theLastBandit/Jammacon/README.md

# Jammacon

Set of adapters to simplify connecting a home console to any Jamma compatible cabinet.

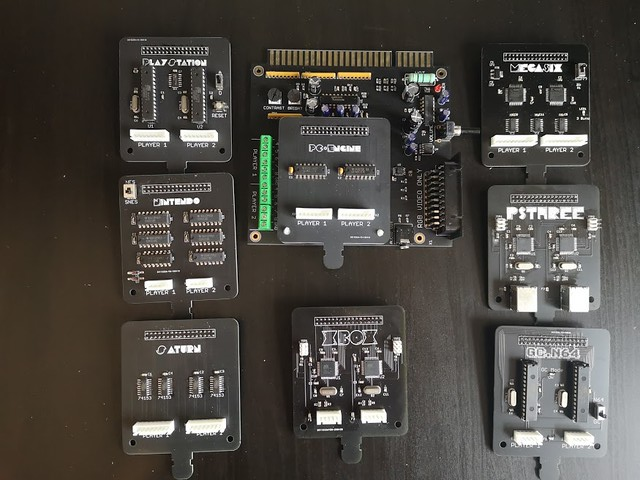
[picture p1: images/jammacon.jpg]
Boards
