theLastBandit/Jammacon/hardware/Readme.md

# BOM

Most components are sourced from either Farnell (F) or Mouser (M), suitable controller cables can be got on Ebay or Aliexpress.
|Board|Ref Des|Part Description|Quantity|Part Number|
|---|---|---|---|---|
|**JammaCon**| | | | |
| |R1, R2, R3, R12, R13, R14|75R SMD 0805|6|2057590 (F)|
| |R4|680K SMD 0805|1|2073825 (F)|
| |R5|2R7 SMD 0805|1|2447631 (F)|
| |R6, R7|10K SMD 0805|2|2073607 (F)|
| |R8, R9, R10|1K SMD 0805|3|2073611 (F)|
| |R11|5K1 SMD 0805|1|2073796 (F)|
| |R18|300R SMD 0805|1|2073728 (F)|
| |R15, R16, R17|430R SMD 0805|3|2138895 (F)|
| |R19, R20|100R SMD 0805|2|2073605 (F)|
| |R21|51K SMD 0805|1|2073797 (F)|
| |R22|3K9 SMD 0805|1|2073760 (F)|
| |R23|20R 5 Watt|1|1903920 (F)|
| |TR1, TR2|5K Trimmer Pot|2|9354697 (F) or 9608222 (F)|
| |POT1|100K Pot|1|1191735 (F)|
| |RN1, RN2, RN3, RN4|4K7 8 Way Resistor Network |4|9357025 (F)|
| |C1, C2, C3, C13, C14, C15, C16, C17, C20, C21, C22, C23, C24, C25, C4, C9|100nF SMD 0805|16|1759143 (F)|
| |C5, C6, C10, C11, C12,  C19, C26|10uF 50V|7|2346601 (F)|
| |C7|47pF SMD 0805|1|1759199 (F)|
| |C8|470uF 16V|1|1236664 (F)|
| |C18, C27|470uF 25V|2|2346508 (F)|
| |C5, C6, C10, C11, C12,  C19, C26|10uF 50V|7|9693769 (F)|
| |U1|TLS1233N Video Amplifier|1|595-TLS1233N (M)|
| |U2|LM1881N Sync Separator|1|1469221 (F)|
| |U3|LM384 Audio Amplifier|1|9488316 (F)|
| |U4|LDFMPT-TR Regulator|1|2460757 (F)|
| |F1|Fuse|1|2460757 (F)|
| |LED1|3mm Red LED|1|2112100 (F)|
| |X1|SCART Vertical Socket|1|806-K-SCARTX-024 (M)|
| |X2|Audio Jack|1|1608405 (F)|
| |X3|34 Pin IDC Male|1| |
| |X4|8 Way Terminal Block|1|3041517 (F)|
| | |PCB Standoff|2|1733396 (F)|
| | |10mm M3 screw|2|1419292 (F)|
|**Saturn**| | | | |
| |IC1, IC2, IC3, IC4|74HC153E|4|1753485 (F)|
| |C1, C2, C3, C4|100nF|4|2112751 (F)|
| |X1, X2|JST-XH 8 Way|2|1516284 (F)|
| |X3|34 Pin IDC Female|1| |
|**Saturn (SMD version)**| | | | |
| |IC1, IC2, IC3, IC4|74HC153D|4|1201248 (F)|
| |C1, C2, C3, C4|100nF SMD 0805|4|1759143 (F)|
| |X1, X2|JST-XH 8 Way|2|1516284 (F)|
| |X3|34 Pin IDC Female|1| |
|**PC-Engine**| | | | |
| |IC1, IC2|74HC157N|2|1750394 (F)|
| |C1, C2|100nF|2|2112751 (F)|
| |X1, X2|JST-XH 8 Way|2|1516284 (F)|
| |X3|34 Pin IDC Female|1| |
|**PC-Engine (SMD version)**| | | | |
| |IC1, IC2|74HC157D|2|1085334 (F)|
| |C1, C2|100nF SMD 0805|2|1759143 (F)|
| |X1, X2|JST-XH 8 Way|2|1516284 (F)|
| |X3|34 Pin IDC Female|1| |
|**Megadrive**| | | | |
| |IC1, IC2|74HC157|2|1750394 (F)|
| |C1, C2|100nF|2|2112751 (F)|
| |X1, X2|JST-XH 10 Way|2|1516286 (F)|
| |X3|34 Pin IDC Female|1| |
|**SNES**| | | | |
| |U1, U2, U3, U4|CD4021|4|2256617 (F)|
| |U5|CD4071|1|1106115 (F)|
| |U6|CD4077|1|1739911 (F)|
| |C1, C2, C3, C4, C5, C6|100nF|6|2112751 (F)|
| |D1, D2|IN4148 Diode|2|9565124 (F)|
| |S1|Switch|1|2435095 (F)|
| |X1, X2|JST-XH 5 Way|2|1516281 (F)|
| |X3|34 Pin IDC Female|1| |
|**SNES (SMD version)**| | | | |
| |U1, U2, U3, U4|CD4021|4|3120814 (F)|
| |U5|CD4071|1|3006431 (F)|
| |U6|CD4077|1|3006434 (F)|
| |C1, C2, C3, C4, C5, C6|100nF SMD 0805|6|1759143 (F)|
| |D1, D2|IN4148 Diode|2|9565124 (F)|
| |S1|Switch|1|2435095 (F)|
| |X1, X2|JST-XH 5 Way|2|1516281 (F)|
| |X3|34 Pin IDC Female|1| |
|**Playstation**| | | | |
| |U1, U2|ATMega328|2|1972087 (F)|
| |U3|75LVC07ADR|1|9592660 (F)|
| |C1, C2, C7|100nF SMD 0805|3|1759143 (F)|
| |C4, C5, C6, C3|22pF SMD 0805|1759195 (F)|
| |R1|10K SMD 0805|1|2073607 (F)|
| |Z1, Z2|16MHz Crystal|2|1611761 (F)|
| |X1, X2|JST-XH 8 Way|2|1516284 (F)|
| |X3|34 Pin IDC Female|1| |
| |S1|Switch|1|1201430 (F)|
| |S2|Button|1| |
|**XBOX**| | | | |
| |U1, U2|ATMega32U4|2|1748525 (F)|
| |C1, C2, C3, C4, C5, C6, C9, C13|100nF SMD 0805|8|1759143 (F)|
| |C7, C8, C11, C12|22pF SMD 0805|4|1759195 (F)|
| |R1, R6|10K SMD 0805|2|2073607 (F)|
| |C10, C14|1uF|2|2320853 (F)|
| |Q1, Q2|16MHz Crystal|2|1611761 (F)|
| |R3, R4, R5, R2|22R SMD 0805|4|2447609 (F)|
| |F1,F2|Fuse|2|581-F0805B0R25FSTR (M)|
| |X1, X2|JST-XH 5 Way|2|1516281 (F)|
| |X3|34 Pin IDC Female|1| |
|**PS3**| | | | |
| |U1, U2|ATMega32U4|2|1748525 (F)|
| |C1, C2, C3, C4, C5, C6, C9, C13|100nF SMD 0805|8|1759143 (F)|
| |C7, C8, C11, C12|22pF SMD 0805|4|1759195 (F)|
| |R1, R6|10K SMD 0805|2|2073607 (F)|
| |C10, C14|1uF|2|2320853 (F)|
| |Q1, Q2|16MHz Crystal|2|1611761 (F)|
| |R3, R4, R5, R2|22R SMD 0805|4|2447609 (F)|
| |F1,F2|Fuse|2|581-F0805B0R25FSTR (M)|
| |X1, X2|USB-A|2|1097897 (F)|
| |X3|34 Pin IDC Female|1| |
|**Megadrive 6**| | | | |
| |IC1, IC4|XC9536XL|2|2831292 (F)|
| |IC2, IC3, IC6|74HC125D|3|1201318 (F)|
| |IC5|3V3 LDO Regulator|1|3257431 (F)|
| |QG1, QG2|10 MHz Oscillator|2|2854358 (F)|
| |C1, C3|4.7uF|2|2409055 (F)|
| |C2, C4, C5, C6, C7, C8, C9, C10, C11, C12, C13|100nF SMD 0805|11|1759143 (F)|
| |R1|300R SMD 0805|1|2073728 (F)|
| |LED1|Red LED|1|2099236 (F)|
| |SW1|Switch|1|1201430 (F)|
| |X1, X2|JST-XH 10 Way|2|1516286 (F)|
| |X3|34 Pin IDC Female|1| |
|**Gamecube & N64**| | | | |
| |U1, U2|ATmega328|2|1972087 (F)|
| |C1, C2|100nF SMD 0805|2||1759143 (F)|
| |C3, C4, C5, C6|22pF SMD 0805|4|1759195 (F)|
| |XTAL1, XTAL2|16MHz Crystal|2|1611761 (F)|
| |R1|300R SMD 0805|1|2073728 (F)|
| |LED1|Red LED|1|2099236 (F)|
| |F1|Fuse|1|581-F0805B0R25FSTR (M)|
| |SW1|Switch|1|1201430 (F)|
| |X1, X2|JST-XH 5 Way|2|1516281 (F)|
| |X3|34 Pin IDC Female|1| |
|**Cables**| | | | |
| | |JST-XH 5 Way| |1516268 (F)|
| | |JST-XH 8 Way| |1516271 (F)|
| | |JST-XH 10 Way| |1516273 (F)|
| | |JST-XH Crimp| |1516301 (F)|
