theLastBandit/Jammacon/hardware/jammacon/jc_audio.kicad_sch

## KiCad design hardware/jammacon/jc_audio.kicad_sch (2022-03-14)

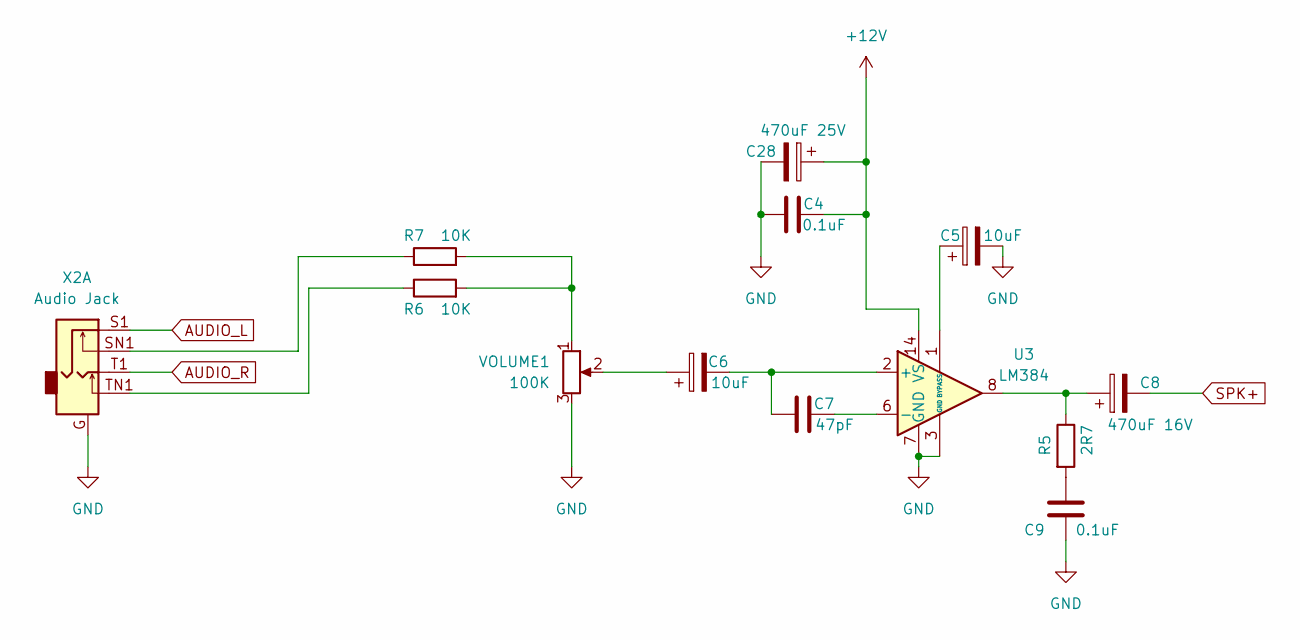
[picture p10: schematic jc_audio.kicad_sch]

Parts:
C4, C9: 0.1uF
C5, C6: 10uF
C7: 47pF
C8: 470uF 16V
C28: 470uF 25V
R5: 2R7
R6, R7: 10K
U3: LM384; DIP-14_W7.62mm
VOLUME1: 100K
X2: Audio Jack

Connections:
+12V: C4.2, C28.1, U3.14 (VS)
AUDIO_L: X2.S1
AUDIO_R: X2.T1
GND: C4.1, C5.2, C9.1, C28.2, U3.3 (GND), U3.4 (GND), U3.5 (GND), U3.7 (GND), U3.10 (GND), U3.11 (GND), U3.12 (GND), VOLUME1.3, X2.G
unnamed: C5.1, U3.1 (BYPASS)
unnamed: C6.1, VOLUME1.2
unnamed: C6.2, C7.1, U3.2 (+)
unnamed: C7.2, U3.6 (-)
unnamed: C8.1, R5.1, U3.8
unnamed: C9.2, R5.2
unnamed: R6.1, X2.TN1
unnamed: R6.2, R7.2, VOLUME1.1
unnamed: R7.1, X2.SN1
SPK+: C8.2
