theLastBandit/Jammacon/hardware/jammacon/jc_io.kicad_sch

## KiCad design hardware/jammacon/jc_io.kicad_sch (2022-03-14)

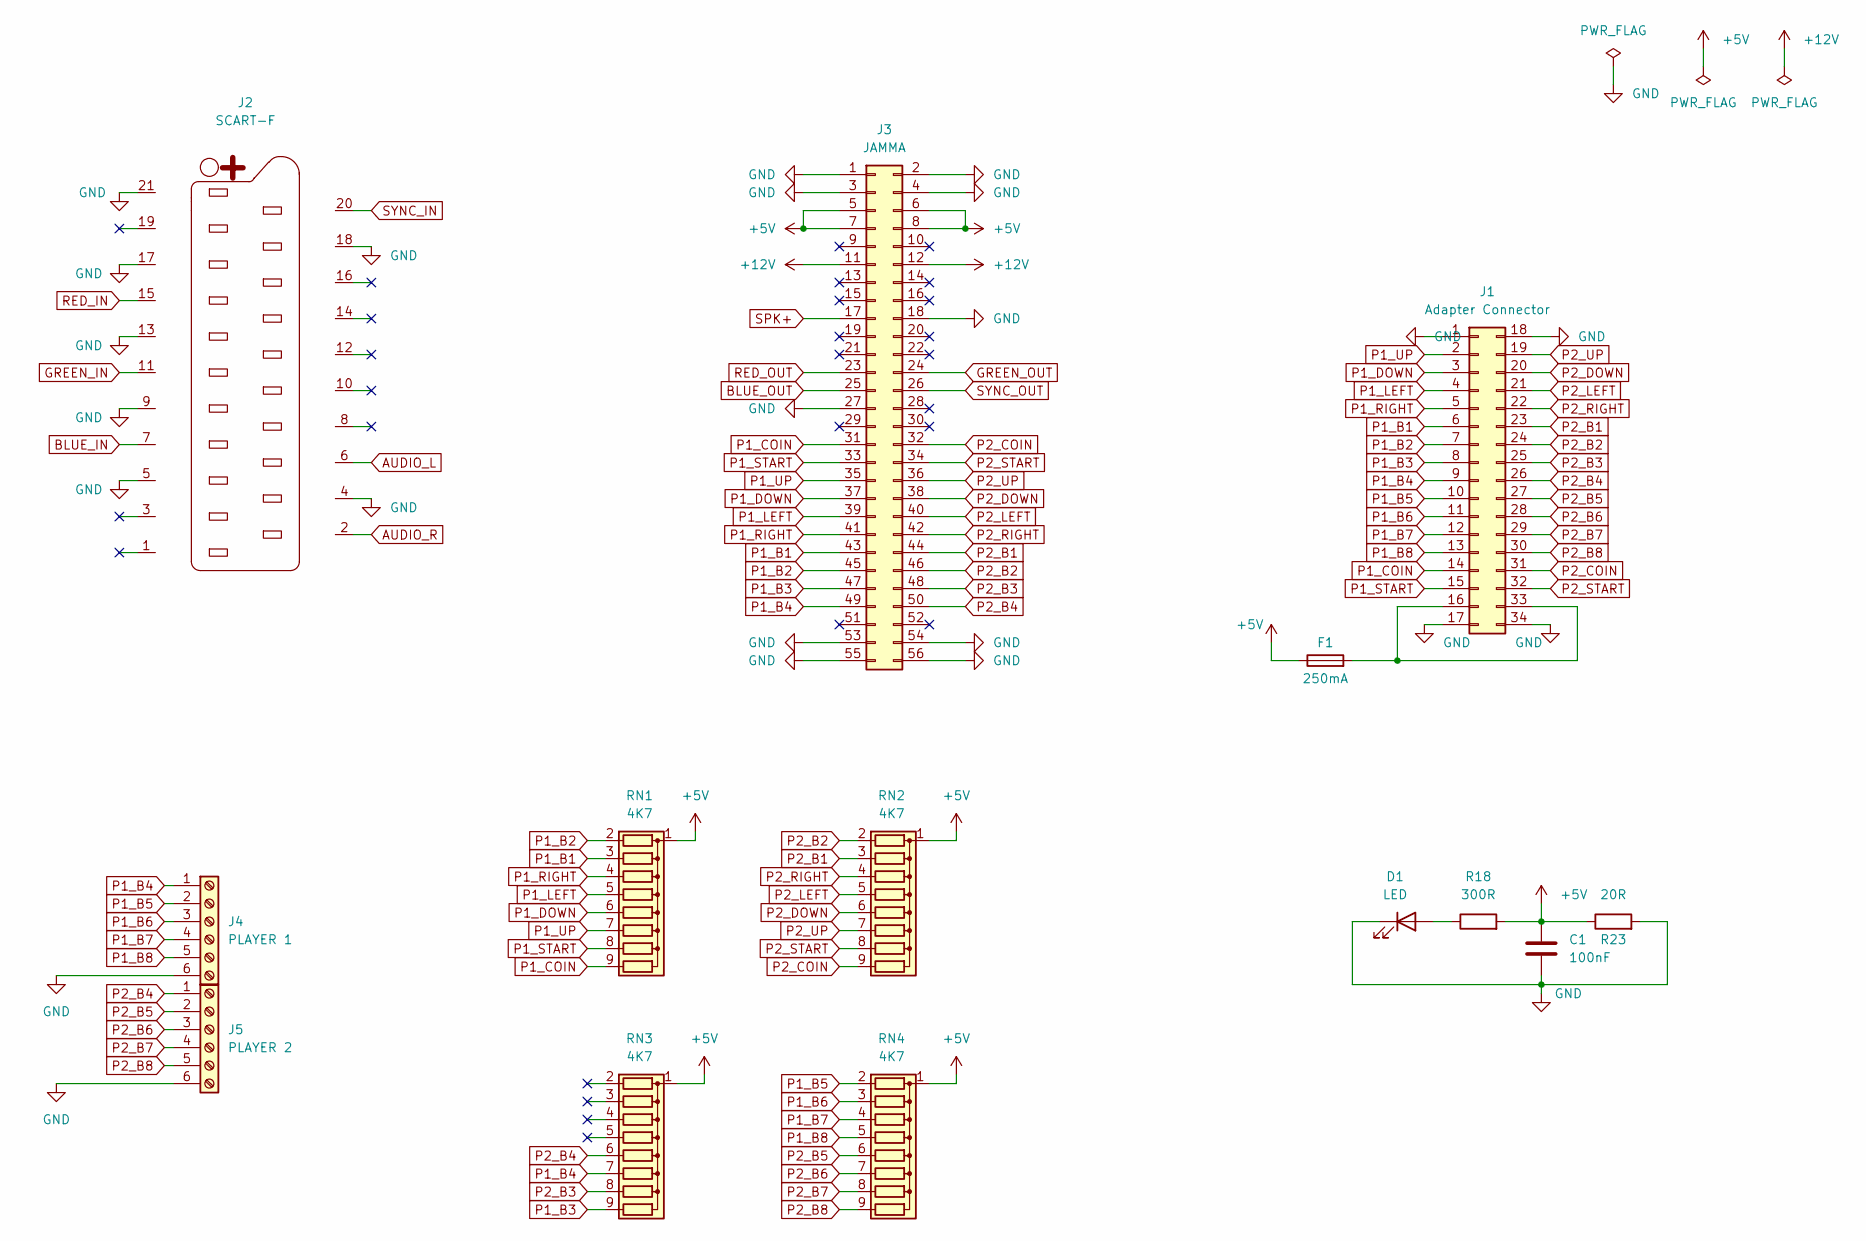
[picture p11: schematic jc_io.kicad_sch]

Parts:
C1: 100nF
D1: LED
F1: 250mA
J1: Adapter Connector
J2: SCART-F
J3: JAMMA
J4: PLAYER 1
J5: PLAYER 2
R18: 300R
R23: 20R
RN1, RN2, RN3, RN4: 4K7; R_Array_SIP9

Connections:
+5V: C1.1, F1.1, J3.5, J3.6, J3.7, J3.8, R18.2, R23.1, RN1.1 (common), RN2.1 (common), RN3.1 (common), RN4.1 (common)
+12V: J3.11, J3.12
AUDIO_L: J2.6
AUDIO_R: J2.2
BLUE_IN: J2.7
BLUE_OUT: J3.25
GND: C1.2, D1.1 (K), J1.1, J1.17, J1.18, J1.34, J2.4, J2.5, J2.9, J2.13, J2.17, J2.18, J2.21, J3.1, J3.2, J3.3, J3.4, J3.18, J3.27, J3.53, J3.54, J3.55, J3.56, J4.6, J5.6, R23.2
GREEN_IN: J2.11
GREEN_OUT: J3.24
unnamed: D1.2 (A), R18.1
unnamed: F1.2, J1.16, J1.33
P1_B1: J1.6, J3.43, RN1.3 (R2)
P1_B2: J1.7, J3.45, RN1.2 (R1)
P1_B3: J1.8, J3.47, RN3.9 (R8)
P1_B4: J1.9, J3.49, J4.1, RN3.7 (R6)
P1_B5: J1.10, J4.2, RN4.2 (R1)
P1_B6: J1.11, J4.3, RN4.3 (R2)
P1_B7: J1.12, J4.4, RN4.4 (R3)
P1_B8: J1.13, J4.5, RN4.5 (R4)
P1_COIN: J1.14, J3.31, RN1.9 (R8)
P1_DOWN: J1.3, J3.37, RN1.6 (R5)
P1_LEFT: J1.4, J3.39, RN1.5 (R4)
P1_RIGHT: J1.5, J3.41, RN1.4 (R3)
P1_START: J1.15, J3.33, RN1.8 (R7)
P1_UP: J1.2, J3.35, RN1.7 (R6)
P2_B1: J1.23, J3.44, RN2.3 (R2)
P2_B2: J1.24, J3.46, RN2.2 (R1)
P2_B3: J1.25, J3.48, RN3.8 (R7)
P2_B4: J1.26, J3.50, J5.1, RN3.6 (R5)
P2_B5: J1.27, J5.2, RN4.6 (R5)
P2_B6: J1.28, J5.3, RN4.7 (R6)
P2_B7: J1.29, J5.4, RN4.8 (R7)
P2_B8: J1.30, J5.5, RN4.9 (R8)
P2_COIN: J1.31, J3.32, RN2.9 (R8)
P2_DOWN: J1.20, J3.38, RN2.6 (R5)
P2_LEFT: J1.21, J3.40, RN2.5 (R4)
P2_RIGHT: J1.22, J3.42, RN2.4 (R3)
P2_START: J1.32, J3.34, RN2.8 (R7)
P2_UP: J1.19, J3.36, RN2.7 (R6)
RED_IN: J2.15
RED_OUT: J3.23
SPK+: J3.17
SYNC_IN: J2.20
SYNC_OUT: J3.26
