theLastBandit/Jammacon/hardware/jammacon/jc_video.kicad_sch

## KiCad design hardware/jammacon/jc_video.kicad_sch (2022-03-14)

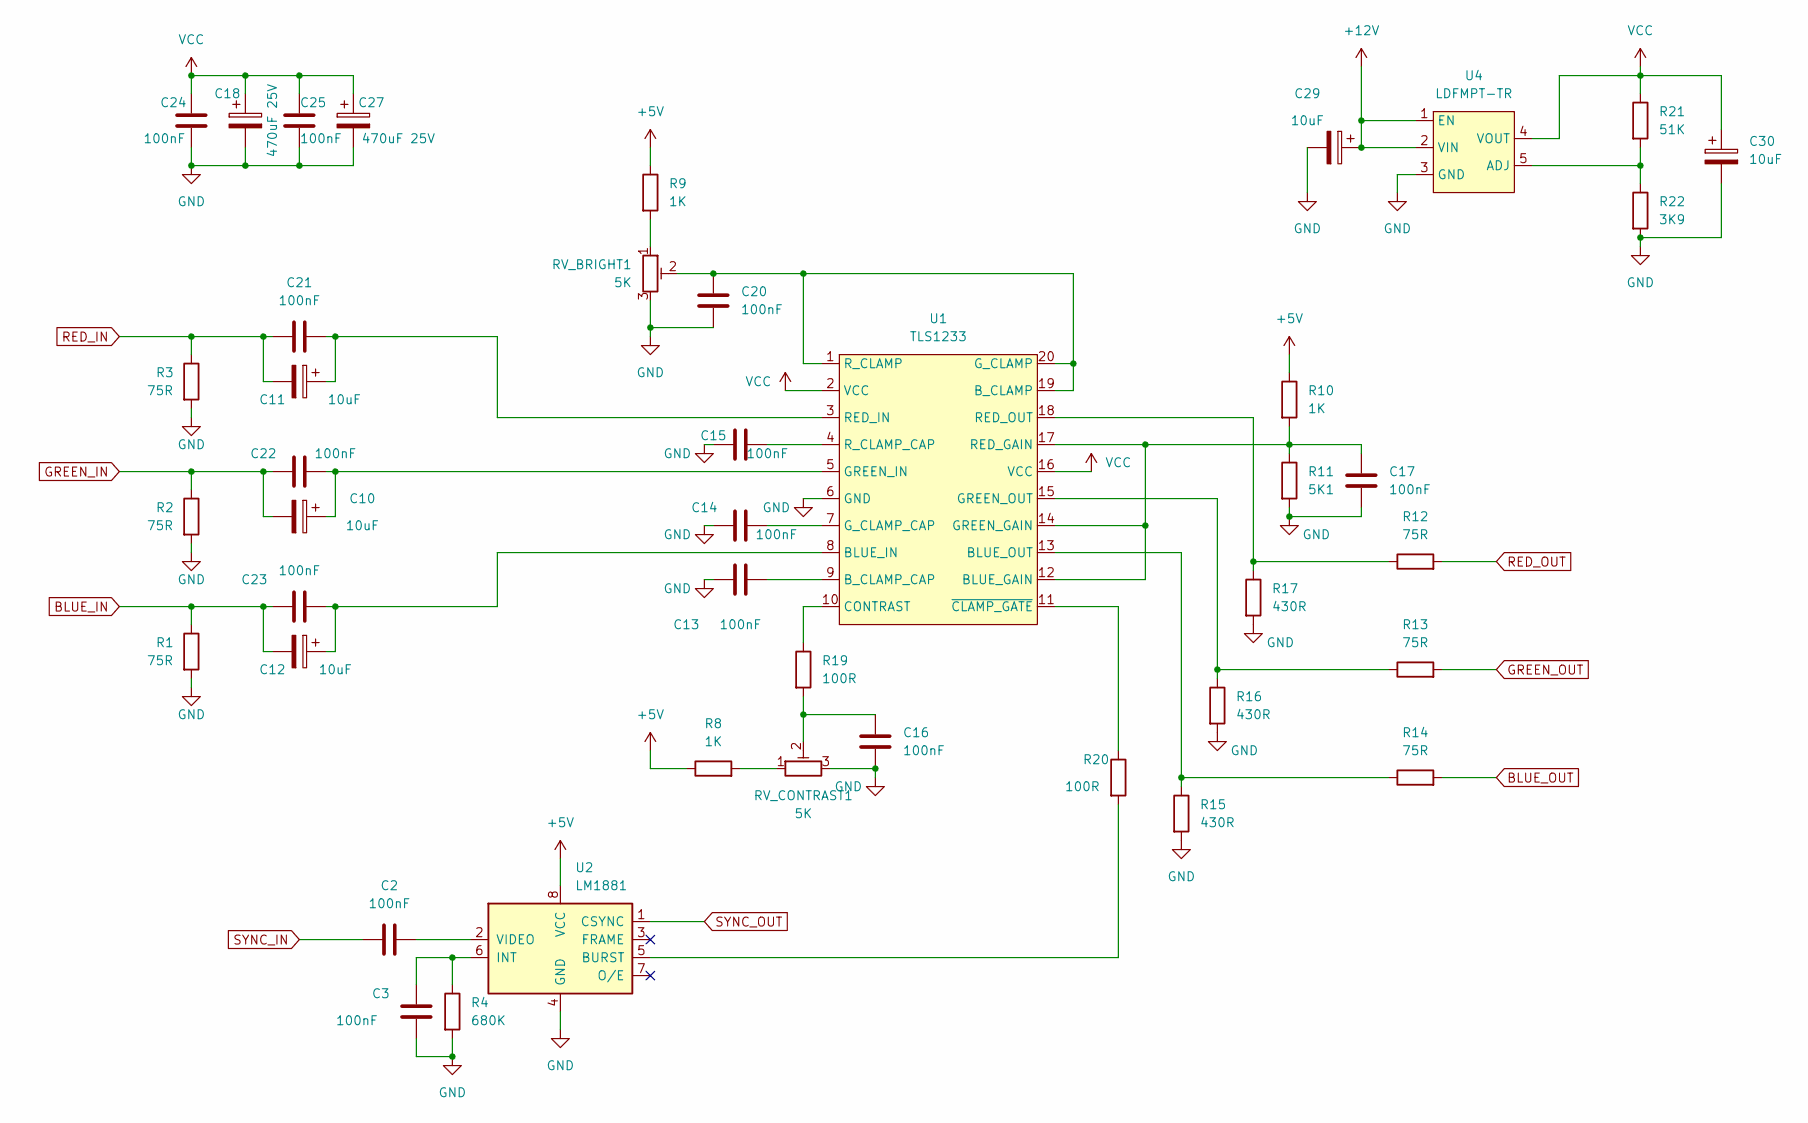
[picture p12: schematic jc_video.kicad_sch]

Parts:
C2, C3, C13, C14, C15, C16, C17, C20, C21, C22, C23, C24, C25: 100nF
C10, C11, C12, C29, C30: 10uF
C18, C27: 470uF 25V
R1, R2, R3, R12, R13, R14: 75R
R4: 680K
R8, R9, R10: 1K
R11: 5K1
R15, R16, R17: 430R
R19, R20: 100R
R21: 51K
R22: 3K9
RV_BRIGHT1: 5K
RV_CONTRAST1: 5K
U1: TLS1233; DIP-20_W7.62mm_LongPads
U2: LM1881
U4: LDFMPT-TR

Connections:
+5V: R8.1, R9.1, R10.1, U2.8 (VCC)
+12V: C29.1, U4.1 (EN), U4.2 (VIN)
BLUE_IN: C12.2, C23.1, R1.1
BLUE_OUT: R14.2
GND: C3.1, C13.1, C14.1, C15.1, C16.2, C17.1, C18.2, C20.1, C24.1, C25.1, C27.2, C29.2, C30.2, R1.2, R2.2, R3.2, R4.2, R11.2, R15.2, R16.2, R17.2, R22.2, RV_BRIGHT1.3, RV_CONTRAST1.3, U1.6 (GND), U2.4 (GND), U4.3 (GND)
GREEN_IN: C10.2, C22.1, R2.1
GREEN_OUT: R13.2
unnamed: C2.2, U2.2 (VIDEO)
unnamed: C3.2, R4.1, U2.6 (INT)
unnamed: C10.1, C22.2, U1.5 (GREEN_IN)
unnamed: C11.1, C21.2, U1.3 (RED_IN)
unnamed: C12.1, C23.2, U1.8 (BLUE_IN)
unnamed: C13.2, U1.9 (B_CLAMP_CAP)
unnamed: C14.2, U1.7 (G_CLAMP_CAP)
unnamed: C15.2, U1.4 (R_CLAMP_CAP)
unnamed: C16.1, R19.2, RV_CONTRAST1.2
unnamed: C17.2, R10.2, R11.1, U1.12 (BLUE_GAIN), U1.14 (GREEN_GAIN), U1.17 (RED_GAIN)
unnamed: C20.2, RV_BRIGHT1.2, U1.1 (R_CLAMP), U1.19 (B_CLAMP), U1.20 (G_CLAMP)
unnamed: R8.2, RV_CONTRAST1.1
unnamed: R9.2, RV_BRIGHT1.1
unnamed: R12.1, R17.1, U1.18 (RED_OUT)
unnamed: R13.1, R16.1, U1.15 (GREEN_OUT)
unnamed: R14.1, R15.1, U1.13 (BLUE_OUT)
unnamed: R19.1, U1.10 (CONTRAST)
unnamed: R20.1, U1.11 (~CLAMP_GATE)
unnamed: R20.2, U2.5 (BURST)
unnamed: R21.2, R22.1, U4.5 (ADJ)
RED_IN: C11.2, C21.1, R3.1
RED_OUT: R12.2
SYNC_IN: C2.1
SYNC_OUT: U2.1 (CSYNC)
VCC: C18.1, C24.2, C25.2, C27.1, C30.1, R21.1, U1.2 (VCC), U1.16 (VCC), U4.4 (VOUT)
