theLastBandit/Jammacon/hardware/jc-megadrive/JC-Megadrive.kicad_sch

## KiCad design hardware/jc-megadrive/JC-Megadrive.kicad_sch (2022-03-14)

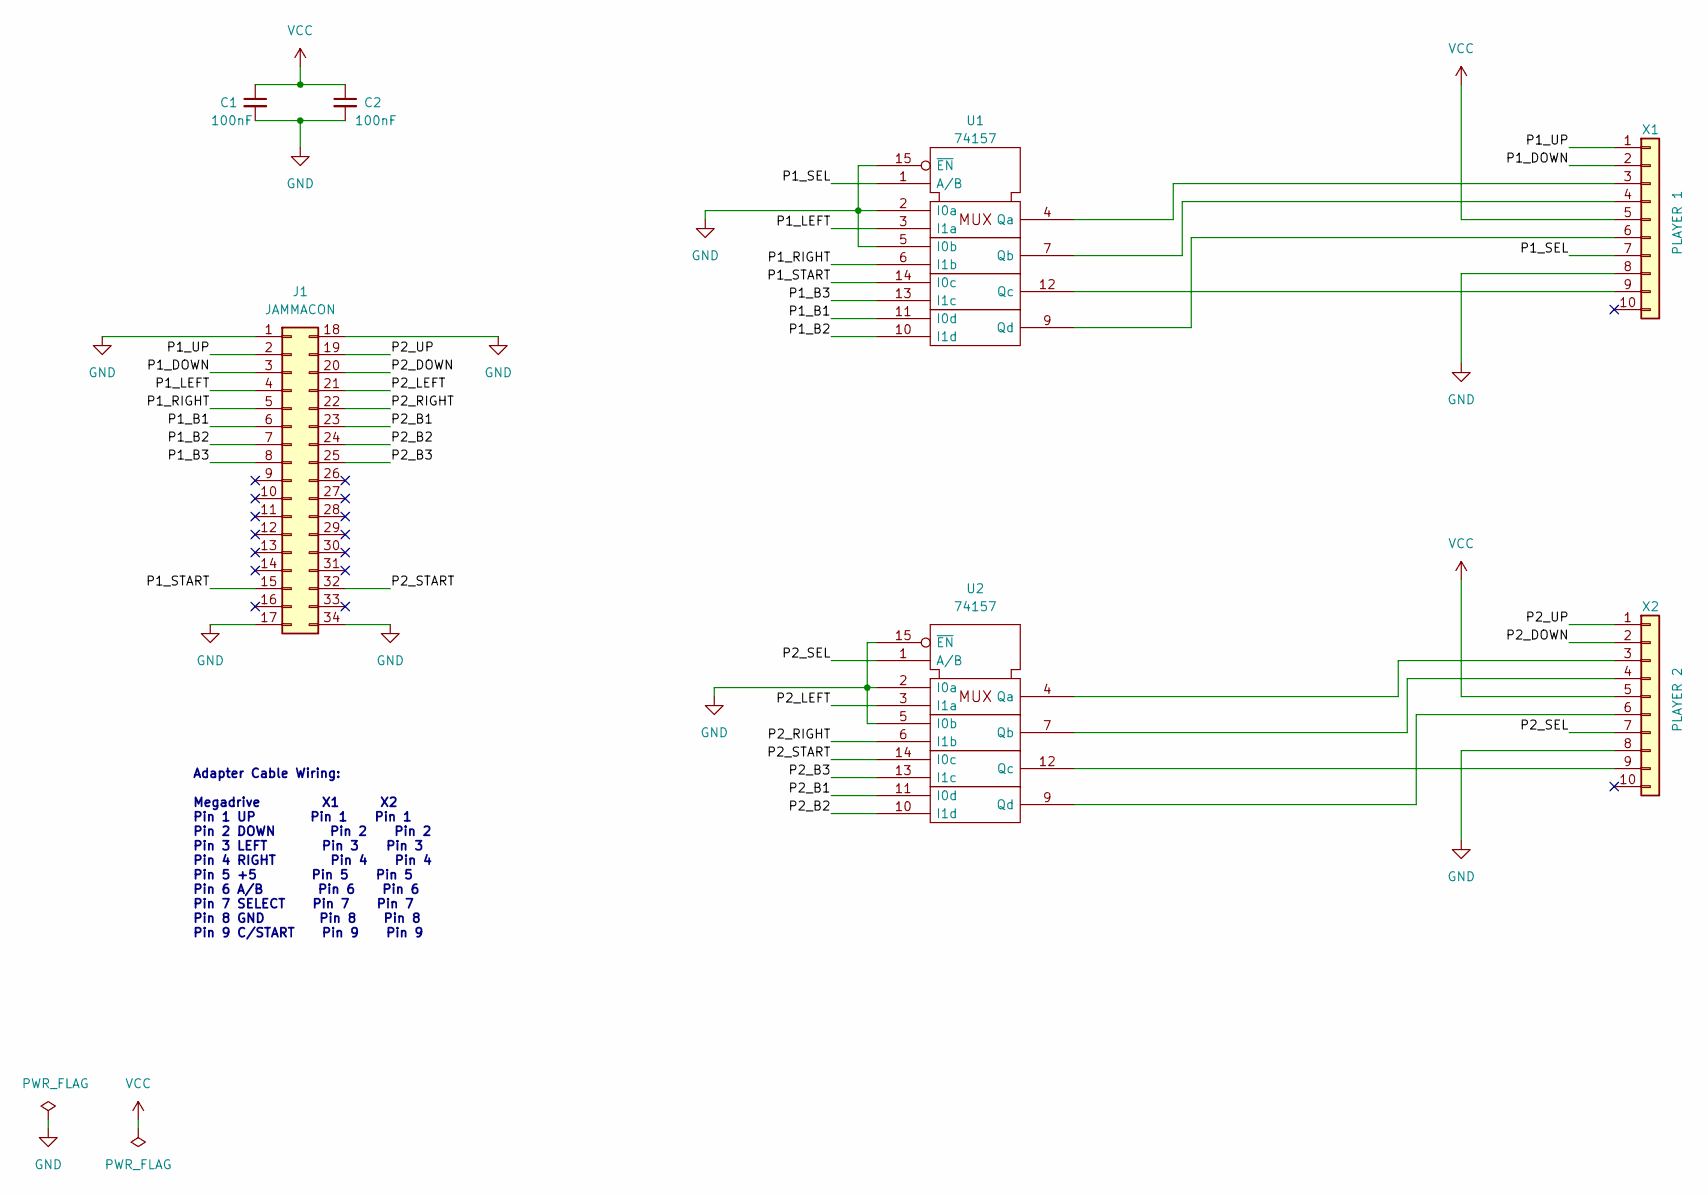
[picture p13: schematic JC-Megadrive.kicad_sch]

Parts:
C1, C2: 100nF
J1: JAMMACON
U1, U2: 74157
X1: PLAYER 1
X2: PLAYER 2

Connections:
GND: C1.2, C2.2, J1.1, J1.17, J1.18, J1.34, U1.2 (I0a), U1.5 (I0b), U1.15 (~EN), U2.2 (I0a), U2.5 (I0b), U2.15 (~EN), X1.8, X2.8
unnamed: U1.4 (Qa), X1.3
unnamed: U1.7 (Qb), X1.4
unnamed: U1.9 (Qd), X1.6
unnamed: U1.12 (Qc), X1.9
unnamed: U2.4 (Qa), X2.3
unnamed: U2.7 (Qb), X2.4
unnamed: U2.9 (Qd), X2.6
unnamed: U2.12 (Qc), X2.9
P1_B1: J1.6, U1.11 (I0d)
P1_B2: J1.7, U1.10 (I1d)
P1_B3: J1.8, U1.13 (I1c)
P1_DOWN: J1.3, X1.2
P1_LEFT: J1.4, U1.3 (I1a)
P1_RIGHT: J1.5, U1.6 (I1b)
P1_SEL: U1.1 (A/B), X1.7
P1_START: J1.15, U1.14 (I0c)
P1_UP: J1.2, X1.1
P2_B1: J1.23, U2.11 (I0d)
P2_B2: J1.24, U2.10 (I1d)
P2_B3: J1.25, U2.13 (I1c)
P2_DOWN: J1.20, X2.2
P2_LEFT: J1.21, U2.3 (I1a)
P2_RIGHT: J1.22, U2.6 (I1b)
P2_SEL: U2.1 (A/B), X2.7
P2_START: J1.32, U2.14 (I0c)
P2_UP: J1.19, X2.1
VCC: C1.1, C2.1, X1.5, X2.5

Notes on the sheet:
Adapter Cable Wiring: Megadrive X1 X2 Pin 1 UP Pin 1 Pin 1 Pin 2 DOWN Pin 2 Pin 2 Pin 3 LEFT Pin 3 Pin 3 Pin 4 RIGHT Pin 4 Pin 4 Pin 5 +5 Pin 5 Pin 5 Pin 6 A/B Pin 6 Pin 6 Pin 7 SELECT Pin 7 Pin 7 Pin 8 GND Pin 8 Pin 8 Pin 9 C/START Pin 9 Pin 9
