theLastBandit/Jammacon/hardware/jc-playstation/JC-Playstation.kicad_sch

## KiCad design hardware/jc-playstation/JC-Playstation.kicad_sch (2022-03-14)

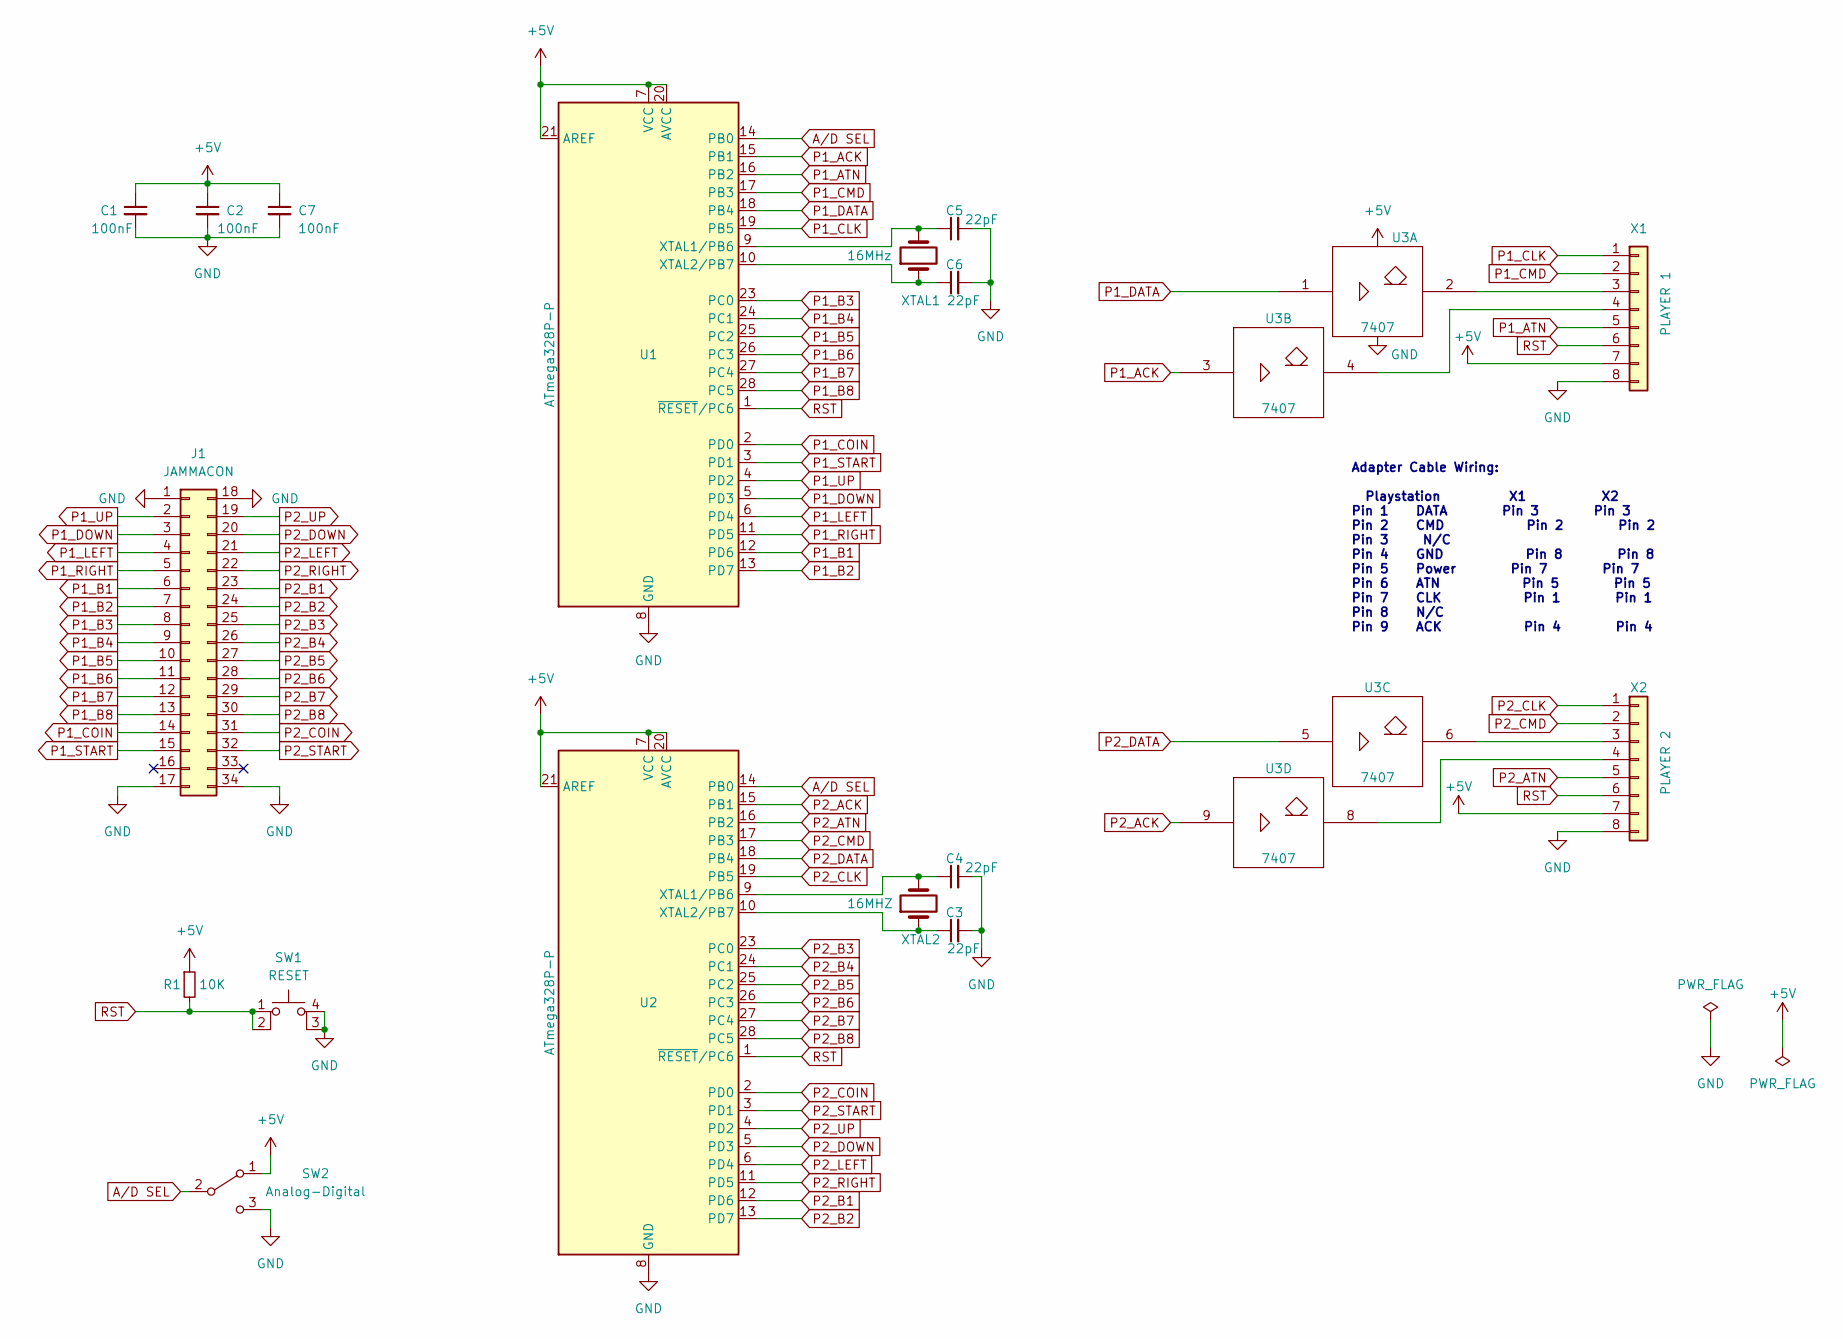
[picture p14: schematic JC-Playstation.kicad_sch]

Parts:
C1, C2, C7: 100nF
C3, C4, C5, C6: 22pF
J1: JAMMACON
R1: 10K
SW1: RESET
SW2: Analog-Digital
U1, U2: ATmega328P-P; DIP-28_W7.62mm
U3: 7407
X1: PLAYER 1
X2: PLAYER 2
XTAL1: 16MHz
XTAL2: 16MHZ

Connections:
+5V: C1.1, C2.1, C7.1, R1.1, SW2.1 (A), U1.7 (VCC), U1.20 (AVCC), U1.21 (AREF), U2.7 (VCC), U2.20 (AVCC), U2.21 (AREF), U3.14 (Vcc), X1.7, X2.7
A/D SEL: SW2.2 (B), U1.14 (PB0), U2.14 (PB0)
GND: C1.2, C2.2, C3.2, C4.2, C5.2, C6.2, C7.2, J1.1, J1.17, J1.18, J1.34, SW1.3 (K), SW1.4 (A), SW2.3 (C), U1.8 (GND), U1.22 (GND), U2.8 (GND), U2.22 (GND), U3.7 (Gnd), X1.8, X2.8
unnamed: C3.1, U2.10 (XTAL2/PB7), XTAL2.1
unnamed: C4.1, U2.9 (XTAL1/PB6), XTAL2.2
unnamed: C5.1, U1.9 (XTAL1/PB6), XTAL1.2
unnamed: C6.1, U1.10 (XTAL2/PB7), XTAL1.1
unnamed: U3.2, X1.3
unnamed: U3.4, X1.4
unnamed: U3.6, X2.3
unnamed: U3.8, X2.4
P1_ACK: U1.15 (PB1), U3.3
P1_ATN: U1.16 (PB2), X1.5
P1_B1: J1.6, U1.12 (PD6)
P1_B2: J1.7, U1.13 (PD7)
P1_B3: J1.8, U1.23 (PC0)
P1_B4: J1.9, U1.24 (PC1)
P1_B5: J1.10, U1.25 (PC2)
P1_B6: J1.11, U1.26 (PC3)
P1_B7: J1.12, U1.27 (PC4)
P1_B8: J1.13, U1.28 (PC5)
P1_CLK: U1.19 (PB5), X1.1
P1_CMD: U1.17 (PB3), X1.2
P1_COIN: J1.14, U1.2 (PD0)
P1_DATA: U1.18 (PB4), U3.1
P1_DOWN: J1.3, U1.5 (PD3)
P1_LEFT: J1.4, U1.6 (PD4)
P1_RIGHT: J1.5, U1.11 (PD5)
P1_START: J1.15, U1.3 (PD1)
P1_UP: J1.2, U1.4 (PD2)
P2_ACK: U2.15 (PB1), U3.9
P2_ATN: U2.16 (PB2), X2.5
P2_B1: J1.23, U2.12 (PD6)
P2_B2: J1.24, U2.13 (PD7)
P2_B3: J1.25, U2.23 (PC0)
P2_B4: J1.26, U2.24 (PC1)
P2_B5: J1.27, U2.25 (PC2)
P2_B6: J1.28, U2.26 (PC3)
P2_B7: J1.29, U2.27 (PC4)
P2_B8: J1.30, U2.28 (PC5)
P2_CLK: U2.19 (PB5), X2.1
P2_CMD: U2.17 (PB3), X2.2
P2_COIN: J1.31, U2.2 (PD0)
P2_DATA: U2.18 (PB4), U3.5
P2_DOWN: J1.20, U2.5 (PD3)
P2_LEFT: J1.21, U2.6 (PD4)
P2_RIGHT: J1.22, U2.11 (PD5)
P2_START: J1.32, U2.3 (PD1)
P2_UP: J1.19, U2.4 (PD2)
RST: R1.2, SW1.1, SW1.2, U1.1 (~RESET/PC6), U2.1 (~RESET/PC6), X1.6, X2.6

Notes on the sheet:
Adapter Cable Wiring: Playstation X1 X2 Pin 1 DATA Pin 3 Pin 3 Pin 2 CMD Pin 2 Pin 2 Pin 3 N/C Pin 4 GND Pin 8 Pin 8 Pin 5 Power Pin 7 Pin 7 Pin 6 ATN Pin 5 Pin 5 Pin 7 CLK Pin 1 Pin 1 Pin 8 N/C Pin 9 ACK Pin 4 Pin 4
