theLastBandit/Jammacon/hardware/jc-saturn/JC-Saturn.kicad_sch

## KiCad design hardware/jc-saturn/JC-Saturn.kicad_sch (2022-03-15)

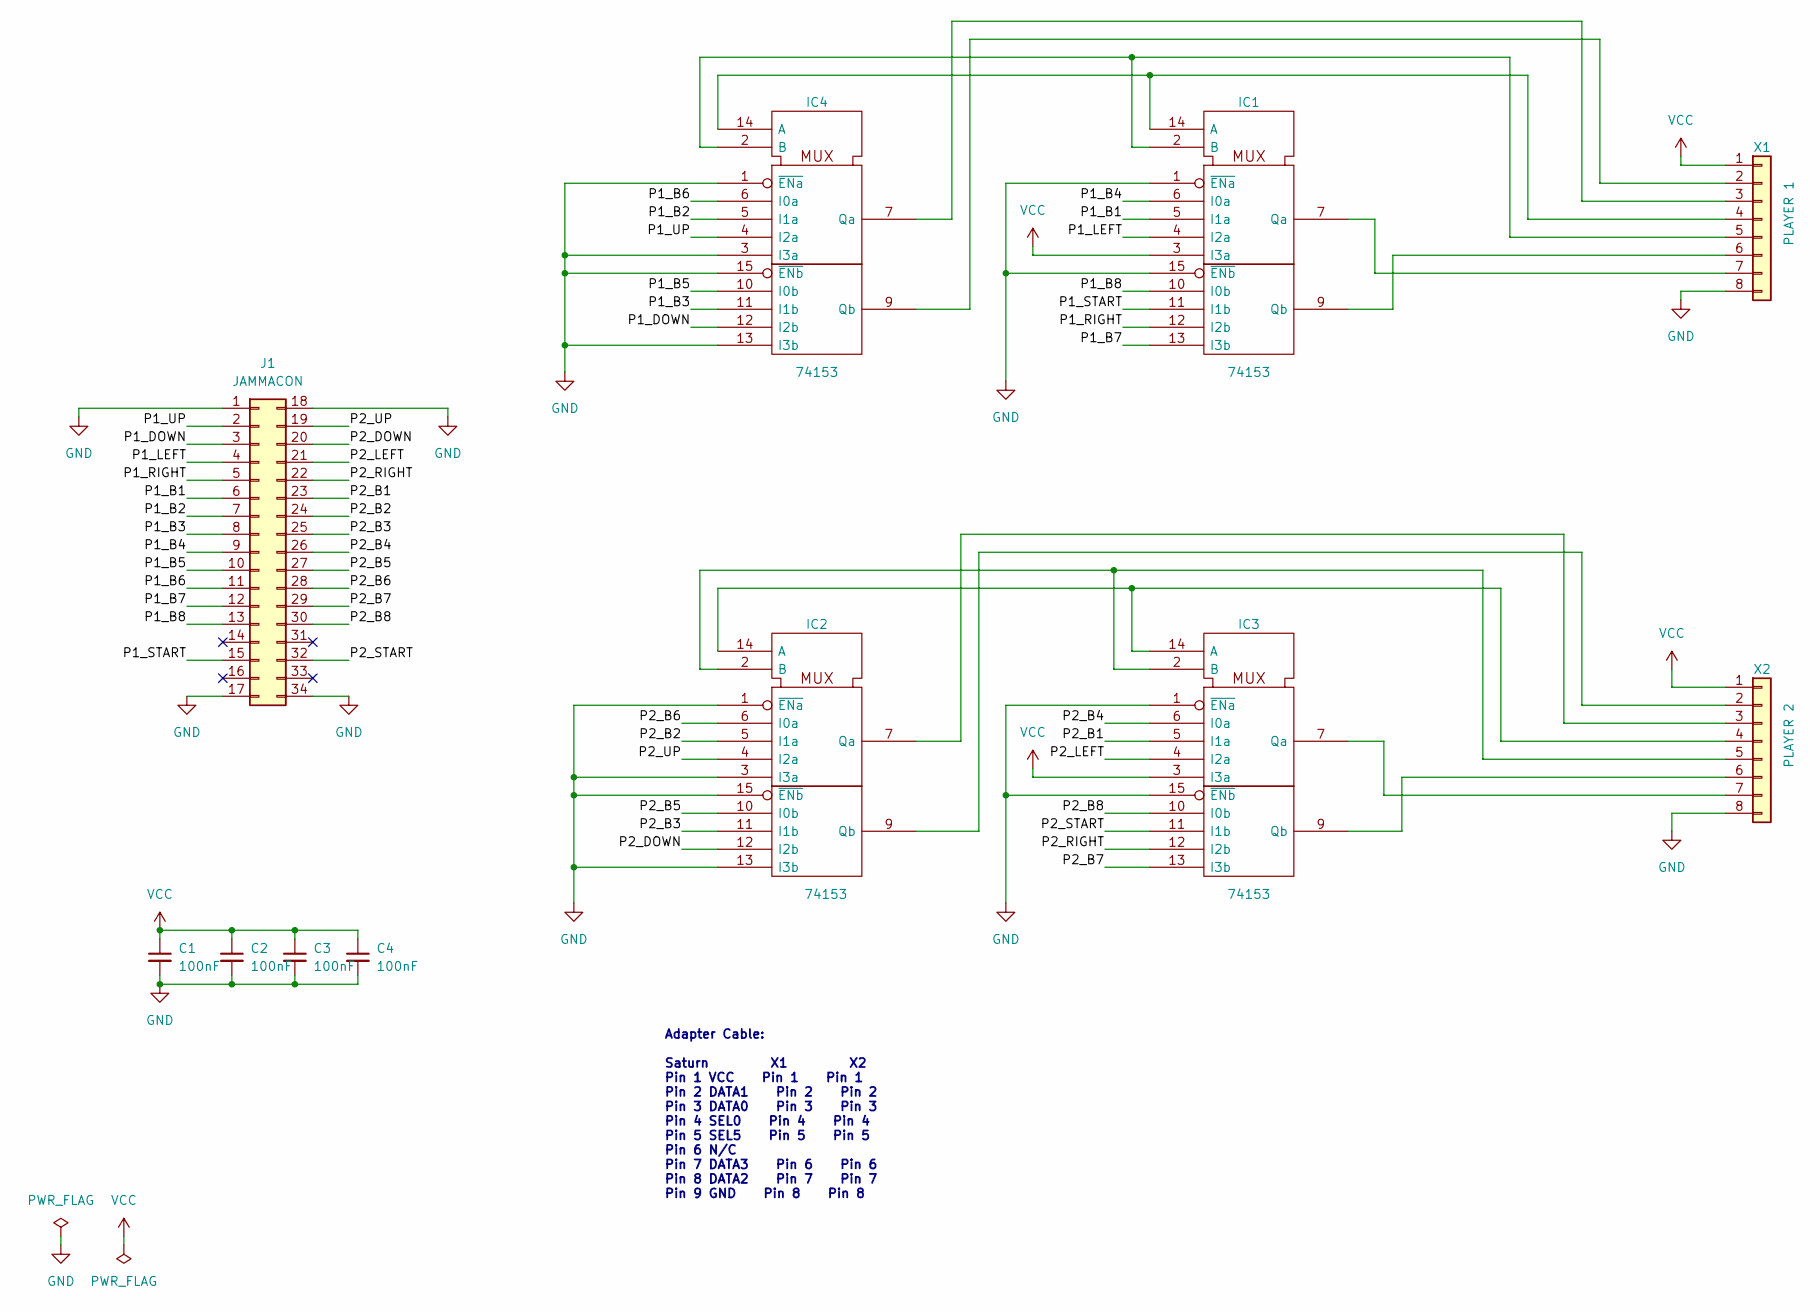
[picture p15: schematic JC-Saturn.kicad_sch]

Parts:
C1, C2, C3, C4: 100nF
IC1, IC2, IC3, IC4: 74153
J1: JAMMACON
X1: PLAYER 1
X2: PLAYER 2

Connections:
GND: C1.2, C2.2, C3.2, C4.2, IC1.1 (~ENa), IC1.15 (~ENb), IC2.1 (~ENa), IC2.3 (I3a), IC2.13 (I3b), IC2.15 (~ENb), IC3.1 (~ENa), IC3.15 (~ENb), IC4.1 (~ENa), IC4.3 (I3a), IC4.13 (I3b), IC4.15 (~ENb), J1.1, J1.17, J1.18, J1.34, X1.8, X2.8
unnamed: IC1.2 (B), IC4.2 (B), X1.5
unnamed: IC1.7 (Qa), X1.7
unnamed: IC1.9 (Qb), X1.6
unnamed: IC1.14 (A), IC4.14 (A), X1.4
unnamed: IC2.2 (B), IC3.2 (B), X2.5
unnamed: IC2.7 (Qa), X2.3
unnamed: IC2.9 (Qb), X2.2
unnamed: IC2.14 (A), IC3.14 (A), X2.4
unnamed: IC3.7 (Qa), X2.7
unnamed: IC3.9 (Qb), X2.6
unnamed: IC4.7 (Qa), X1.3
unnamed: IC4.9 (Qb), X1.2
P1_B1: IC1.5 (I1a), J1.6
P1_B2: IC4.5 (I1a), J1.7
P1_B3: IC4.11 (I1b), J1.8
P1_B4: IC1.6 (I0a), J1.9
P1_B5: IC4.10 (I0b), J1.10
P1_B6: IC4.6 (I0a), J1.11
P1_B7: IC1.13 (I3b), J1.12
P1_B8: IC1.10 (I0b), J1.13
P1_DOWN: IC4.12 (I2b), J1.3
P1_LEFT: IC1.4 (I2a), J1.4
P1_RIGHT: IC1.12 (I2b), J1.5
P1_START: IC1.11 (I1b), J1.15
P1_UP: IC4.4 (I2a), J1.2
P2_B1: IC3.5 (I1a), J1.23
P2_B2: IC2.5 (I1a), J1.24
P2_B3: IC2.11 (I1b), J1.25
P2_B4: IC3.6 (I0a), J1.26
P2_B5: IC2.10 (I0b), J1.27
P2_B6: IC2.6 (I0a), J1.28
P2_B7: IC3.13 (I3b), J1.29
P2_B8: IC3.10 (I0b), J1.30
P2_DOWN: IC2.12 (I2b), J1.20
P2_LEFT: IC3.4 (I2a), J1.21
P2_RIGHT: IC3.12 (I2b), J1.22
P2_START: IC3.11 (I1b), J1.32
P2_UP: IC2.4 (I2a), J1.19
VCC: C1.1, C2.1, C3.1, C4.1, IC1.3 (I3a), IC3.3 (I3a), X1.1, X2.1

Notes on the sheet:
Adapter Cable: Saturn X1 X2 Pin 1 VCC Pin 1 Pin 1 Pin 2 DATA1 Pin 2 Pin 2 Pin 3 DATA0 Pin 3 Pin 3 Pin 4 SEL0 Pin 4 Pin 4 Pin 5 SEL5 Pin 5 Pin 5 Pin 6 N/C Pin 7 DATA3 Pin 6 Pin 6 Pin 8 DATA2 Pin 7 Pin 7 Pin 9 GND Pin 8 Pin 8
