theLastBandit/Jammacon/hardware/jc-snes/JC-SNES.kicad_sch

## KiCad design hardware/jc-snes/JC-SNES.kicad_sch (2022-03-16)

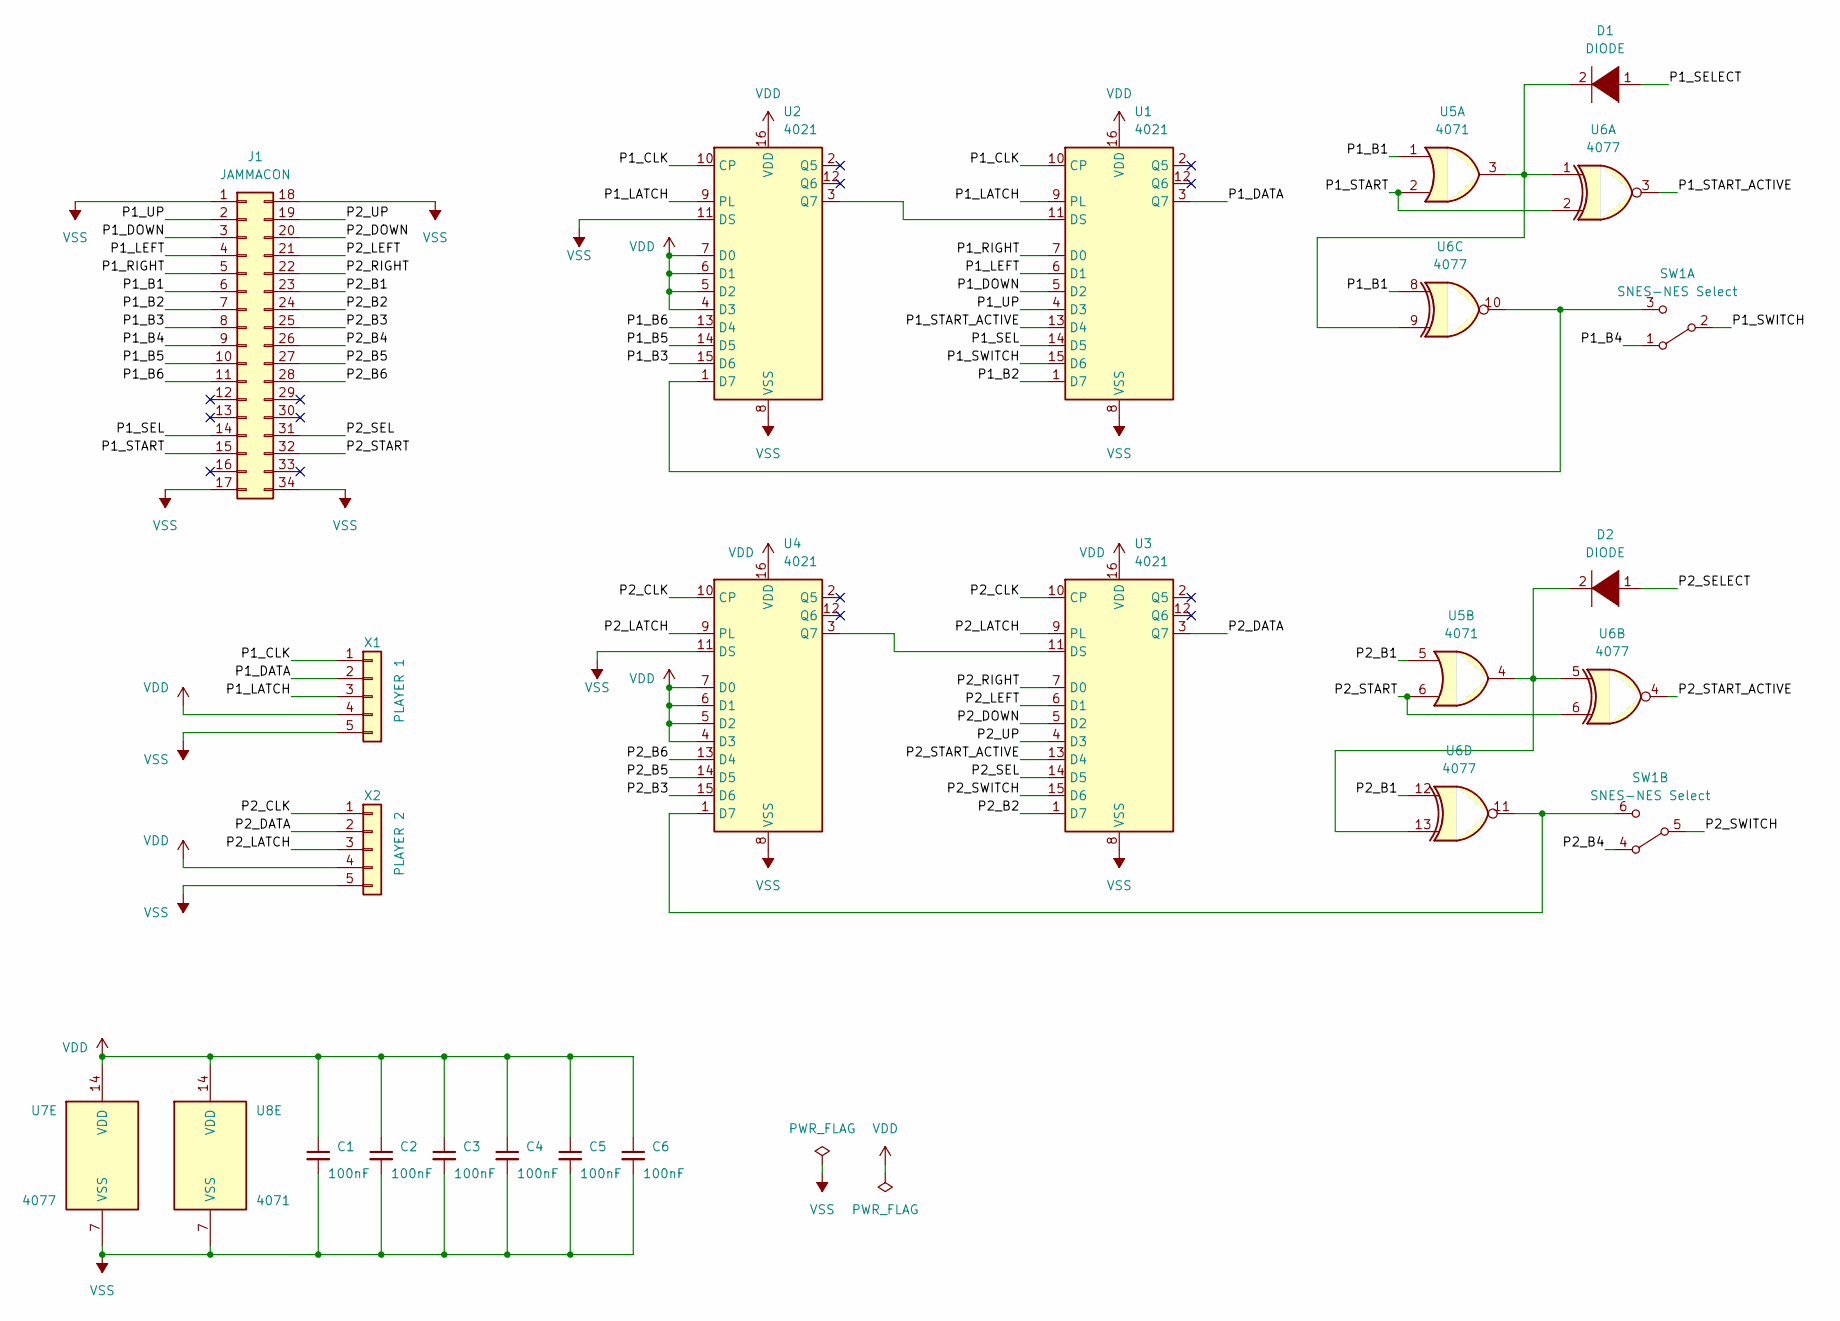
[picture p16: schematic JC-SNES.kicad_sch]

Parts:
C1, C2, C3, C4, C5, C6: 100nF
D1, D2: DIODE
J1: JAMMACON
SW1: SNES-NES Select
U1, U2, U3, U4: 4021
U5, U8: 4071
U6, U7: 4077
X1: PLAYER 1
X2: PLAYER 2

Connections:
unnamed: D1.2 (A), U5.3, U6.1, U6.9
unnamed: D2.2 (A), U5.4, U6.5, U6.13
unnamed: SW1.3 (C), U2.1 (D7), U6.10
unnamed: SW1.6 (C), U4.1 (D7), U6.11
unnamed: U1.11 (DS), U2.3 (Q7)
unnamed: U3.11 (DS), U4.3 (Q7)
P1_B1: J1.6, U5.1, U6.8
P1_B2: J1.7, U1.1 (D7)
P1_B3: J1.8, U2.15 (D6)
P1_B4: J1.9, SW1.1 (A)
P1_B5: J1.10, U2.14 (D5)
P1_B6: J1.11, U2.13 (D4)
P1_CLK: U1.10 (CP), U2.10 (CP), X1.1
P1_DATA: U1.3 (Q7), X1.2
P1_DOWN: J1.3, U1.5 (D2)
P1_LATCH: U1.9 (PL), U2.9 (PL), X1.3
P1_LEFT: J1.4, U1.6 (D1)
P1_RIGHT: J1.5, U1.7 (D0)
P1_SEL: J1.14, U1.14 (D5)
P1_SELECT: D1.1 (K)
P1_START: J1.15, U5.2, U6.2
P1_START_ACTIVE: U1.13 (D4), U6.3
P1_SWITCH: SW1.2 (B), U1.15 (D6)
P1_UP: J1.2, U1.4 (D3)
P2_B1: J1.23, U5.5, U6.12
P2_B2: J1.24, U3.1 (D7)
P2_B3: J1.25, U4.15 (D6)
P2_B4: J1.26, SW1.4 (A)
P2_B5: J1.27, U4.14 (D5)
P2_B6: J1.28, U4.13 (D4)
P2_CLK: U3.10 (CP), U4.10 (CP), X2.1
P2_DATA: U3.3 (Q7), X2.2
P2_DOWN: J1.20, U3.5 (D2)
P2_LATCH: U3.9 (PL), U4.9 (PL), X2.3
P2_LEFT: J1.21, U3.6 (D1)
P2_RIGHT: J1.22, U3.7 (D0)
P2_SEL: J1.31, U3.14 (D5)
P2_SELECT: D2.1 (K)
P2_START: J1.32, U5.6, U6.6
P2_START_ACTIVE: U3.13 (D4), U6.4
P2_SWITCH: SW1.5 (B), U3.15 (D6)
P2_UP: J1.19, U3.4 (D3)
VDD: C1.1, C2.1, C3.1, C4.1, C5.1, C6.1, U1.16 (VDD), U2.4 (D3), U2.5 (D2), U2.6 (D1), U2.7 (D0), U2.16 (VDD), U3.16 (VDD), U4.4 (D3), U4.5 (D2), U4.6 (D1), U4.7 (D0), U4.16 (VDD), U7.14 (VDD), U8.14 (VDD), X1.4, X2.4
VSS: C1.2, C2.2, C3.2, C4.2, C5.2, C6.2, J1.1, J1.17, J1.18, J1.34, U1.8 (VSS), U2.8 (VSS), U2.11 (DS), U3.8 (VSS), U4.8 (VSS), U4.11 (DS), U7.7 (VSS), U8.7 (VSS), X1.5, X2.5
